wizarddevelopment/statusbot/img/2014-07-06 00.10.05.jpg

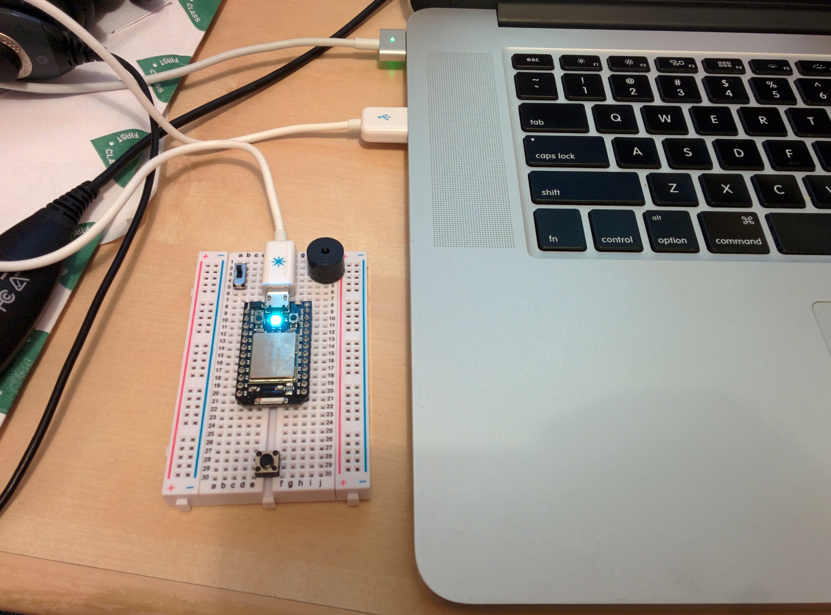
img/2014-07-06 00.10.05.jpg
