wizarddevelopment/statusbot/img/2014-07-06 14.59.45.jpg

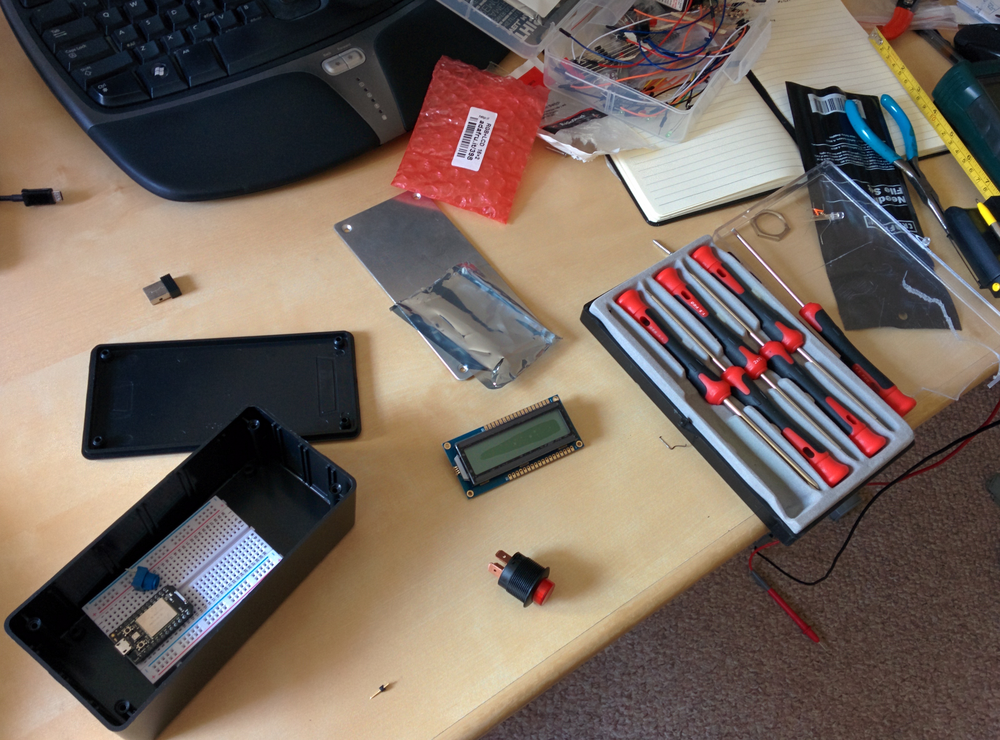
img/2014-07-06 14.59.45.jpg
