wizarddevelopment/statusbot/img/2014-07-06 15.12.53.jpg

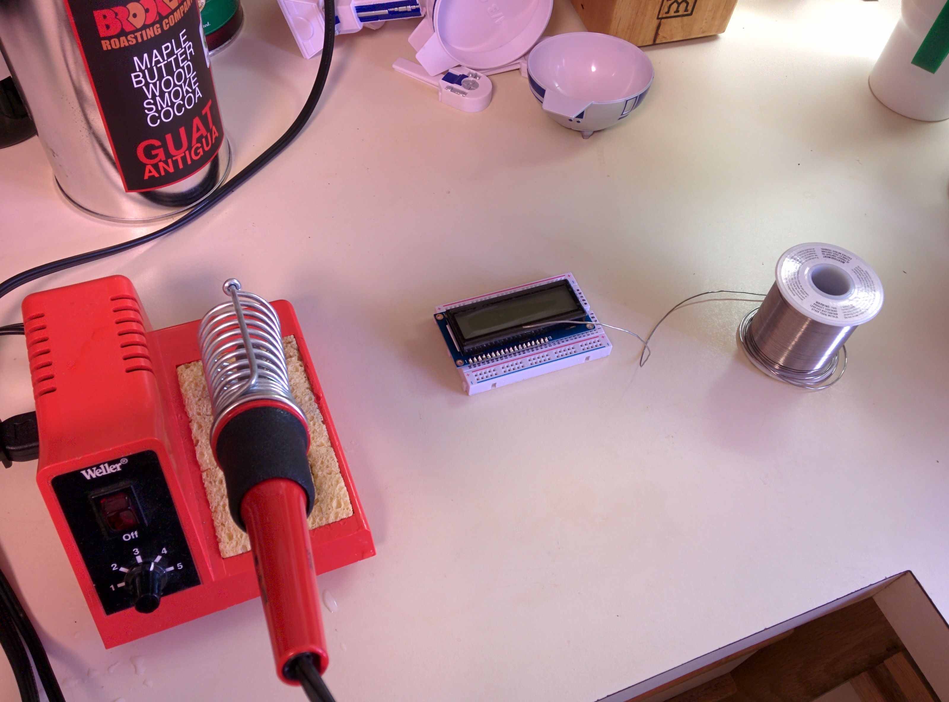
img/2014-07-06 15.12.53.jpg
