wizarddevelopment/statusbot/img/2014-07-06 15.51.53.jpg

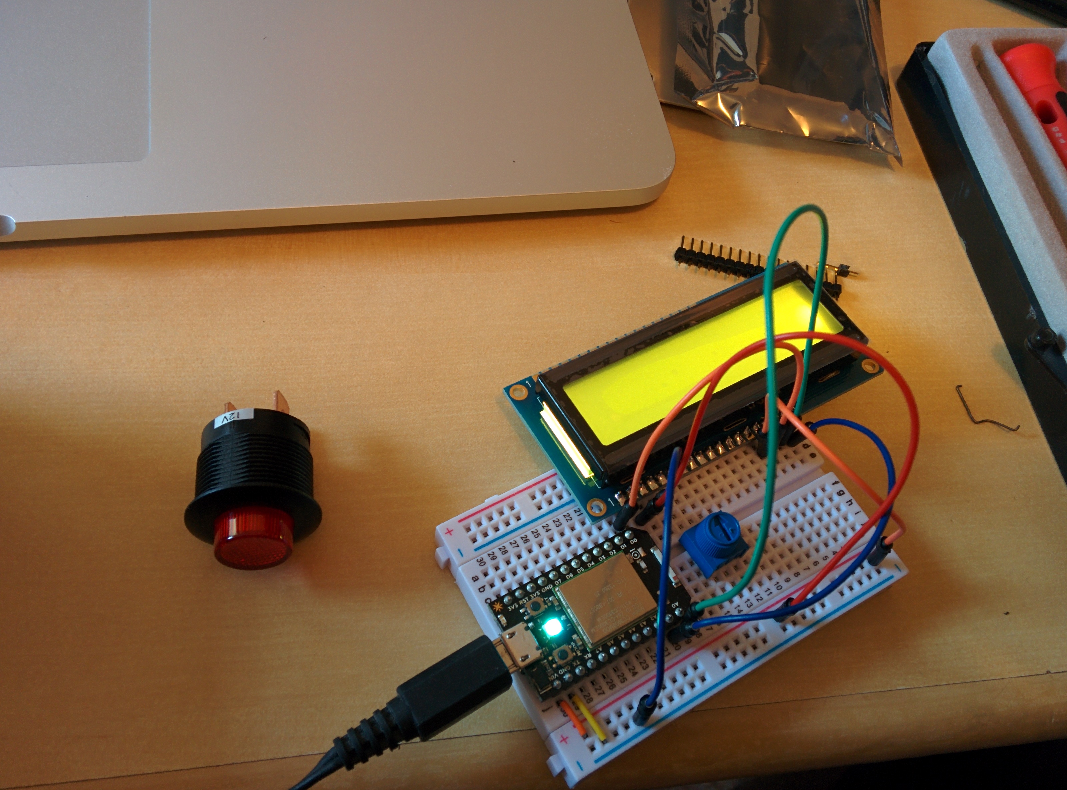
img/2014-07-06 15.51.53.jpg
