wizarddevelopment/statusbot/img/2014-07-06 15.52.10.jpg

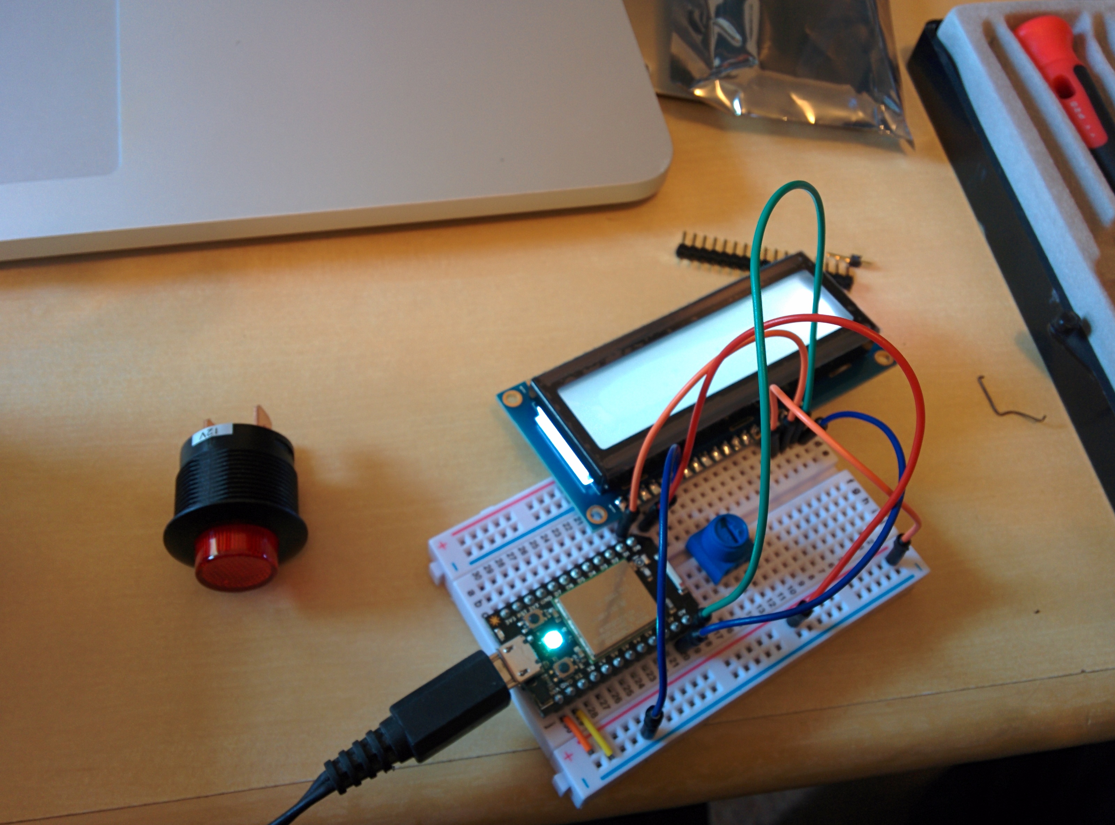
img/2014-07-06 15.52.10.jpg
