wizarddevelopment/statusbot/img/2014-07-06 18.22.54.jpg

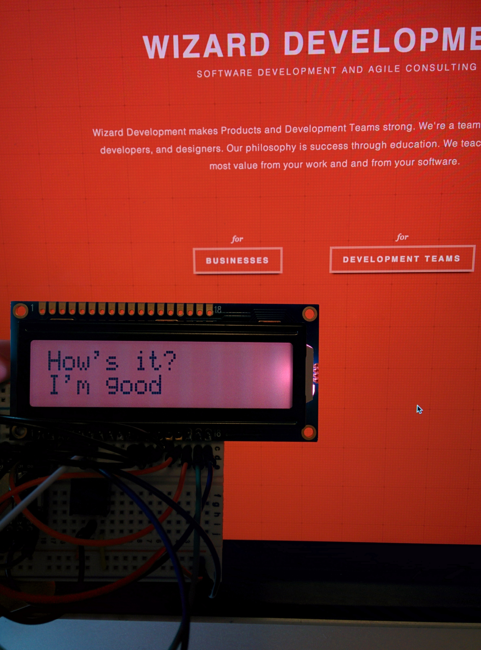
img/2014-07-06 18.22.54.jpg
