wizarddevelopment/statusbot/img/2014-07-06 22.27.15.jpg

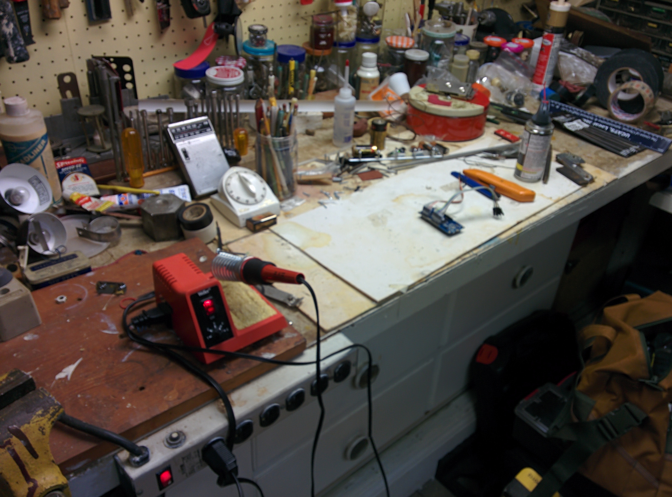
img/2014-07-06 22.27.15.jpg
