wizarddevelopment/statusbot/img/2014-07-07 15.54.55.jpg

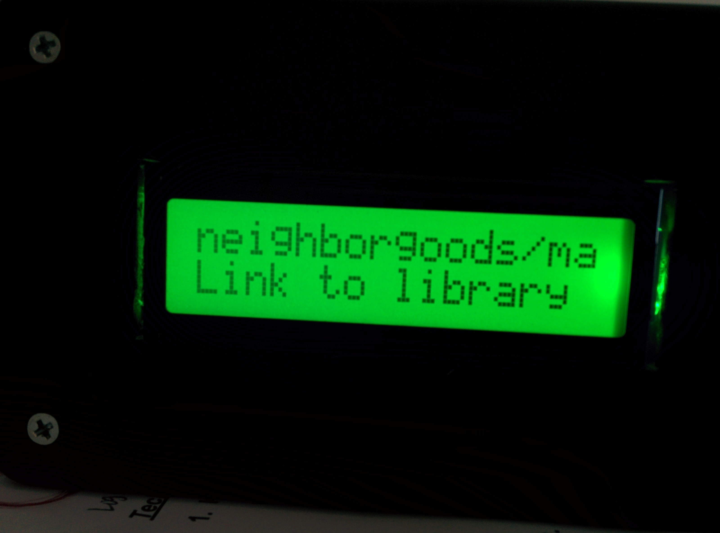
img/2014-07-07 15.54.55.jpg
