wizarddevelopment/statusbot/img/2014-07-07 15.54.59.jpg

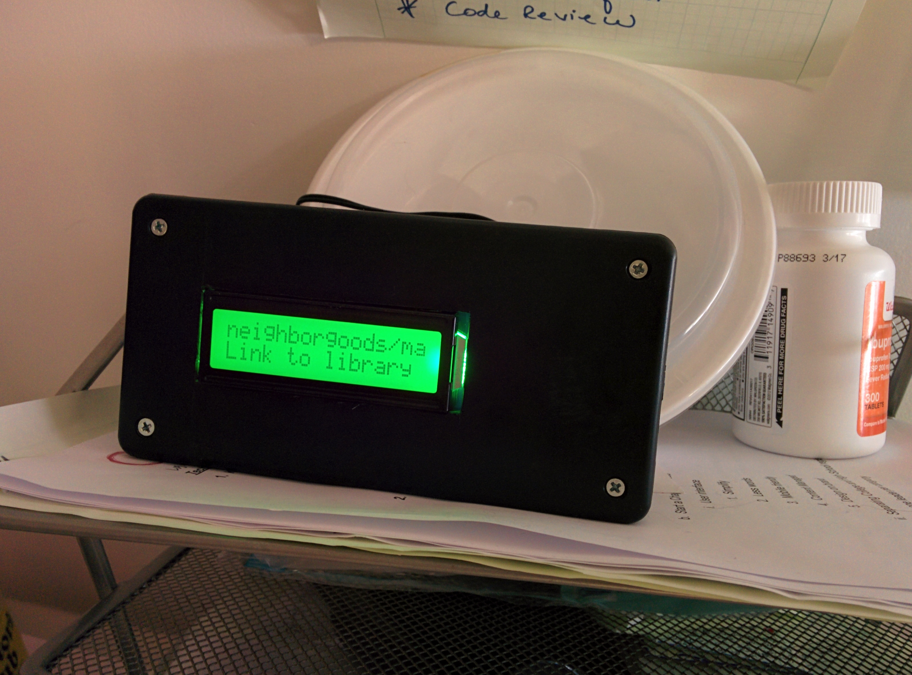
img/2014-07-07 15.54.59.jpg
