wizarddevelopment/statusbot/img/desk.jpg

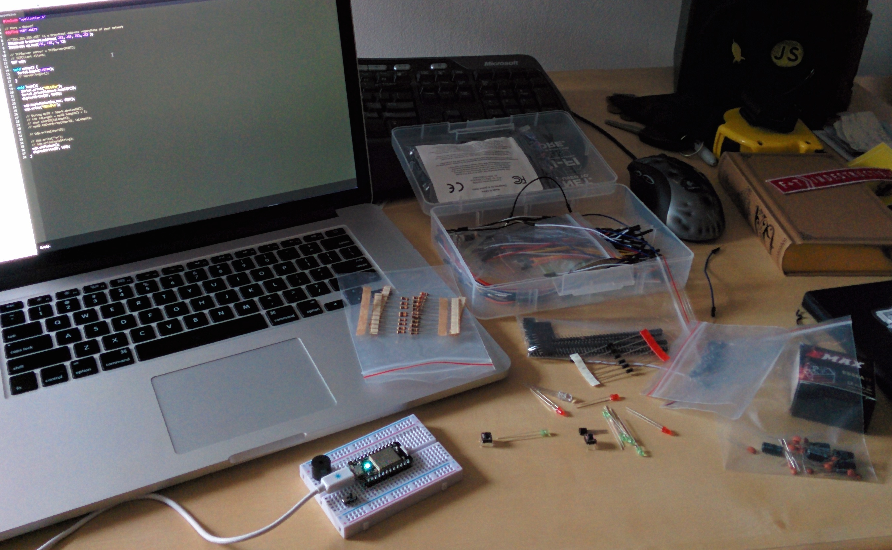
img/desk.jpg
