wizarddevelopment/statusbot/(commit log)

2014-07-05 first cut
2014-07-05 don’t log in production
2014-07-06 Allow two line messages to be sent, and update sparkNotifier to do the right thing.
    - Add a /test route for fun
    - spark.backlight(hexcolorcode)
    - spark.write(“two\nline message”)
2014-07-06 I’ll never be happy with these colors
2014-07-07 don’t need this
